lpdon/xmobile/README.md

# X-Mobile #

### What is this repository for? ###

Repository for the development of the version 2015 of the X-Mobile robot.
