lpdon/xmobile/remote control/Conectores.brd

## EAGLE design remote control/Conectores.brd (2015-06-17)

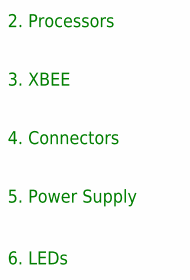
[picture p1: schematic Conectores.sch, sheet 1]

Notes on the sheet:
2. Processors
3. XBEE
4. Connectors
5. Power Supply
6. LEDs

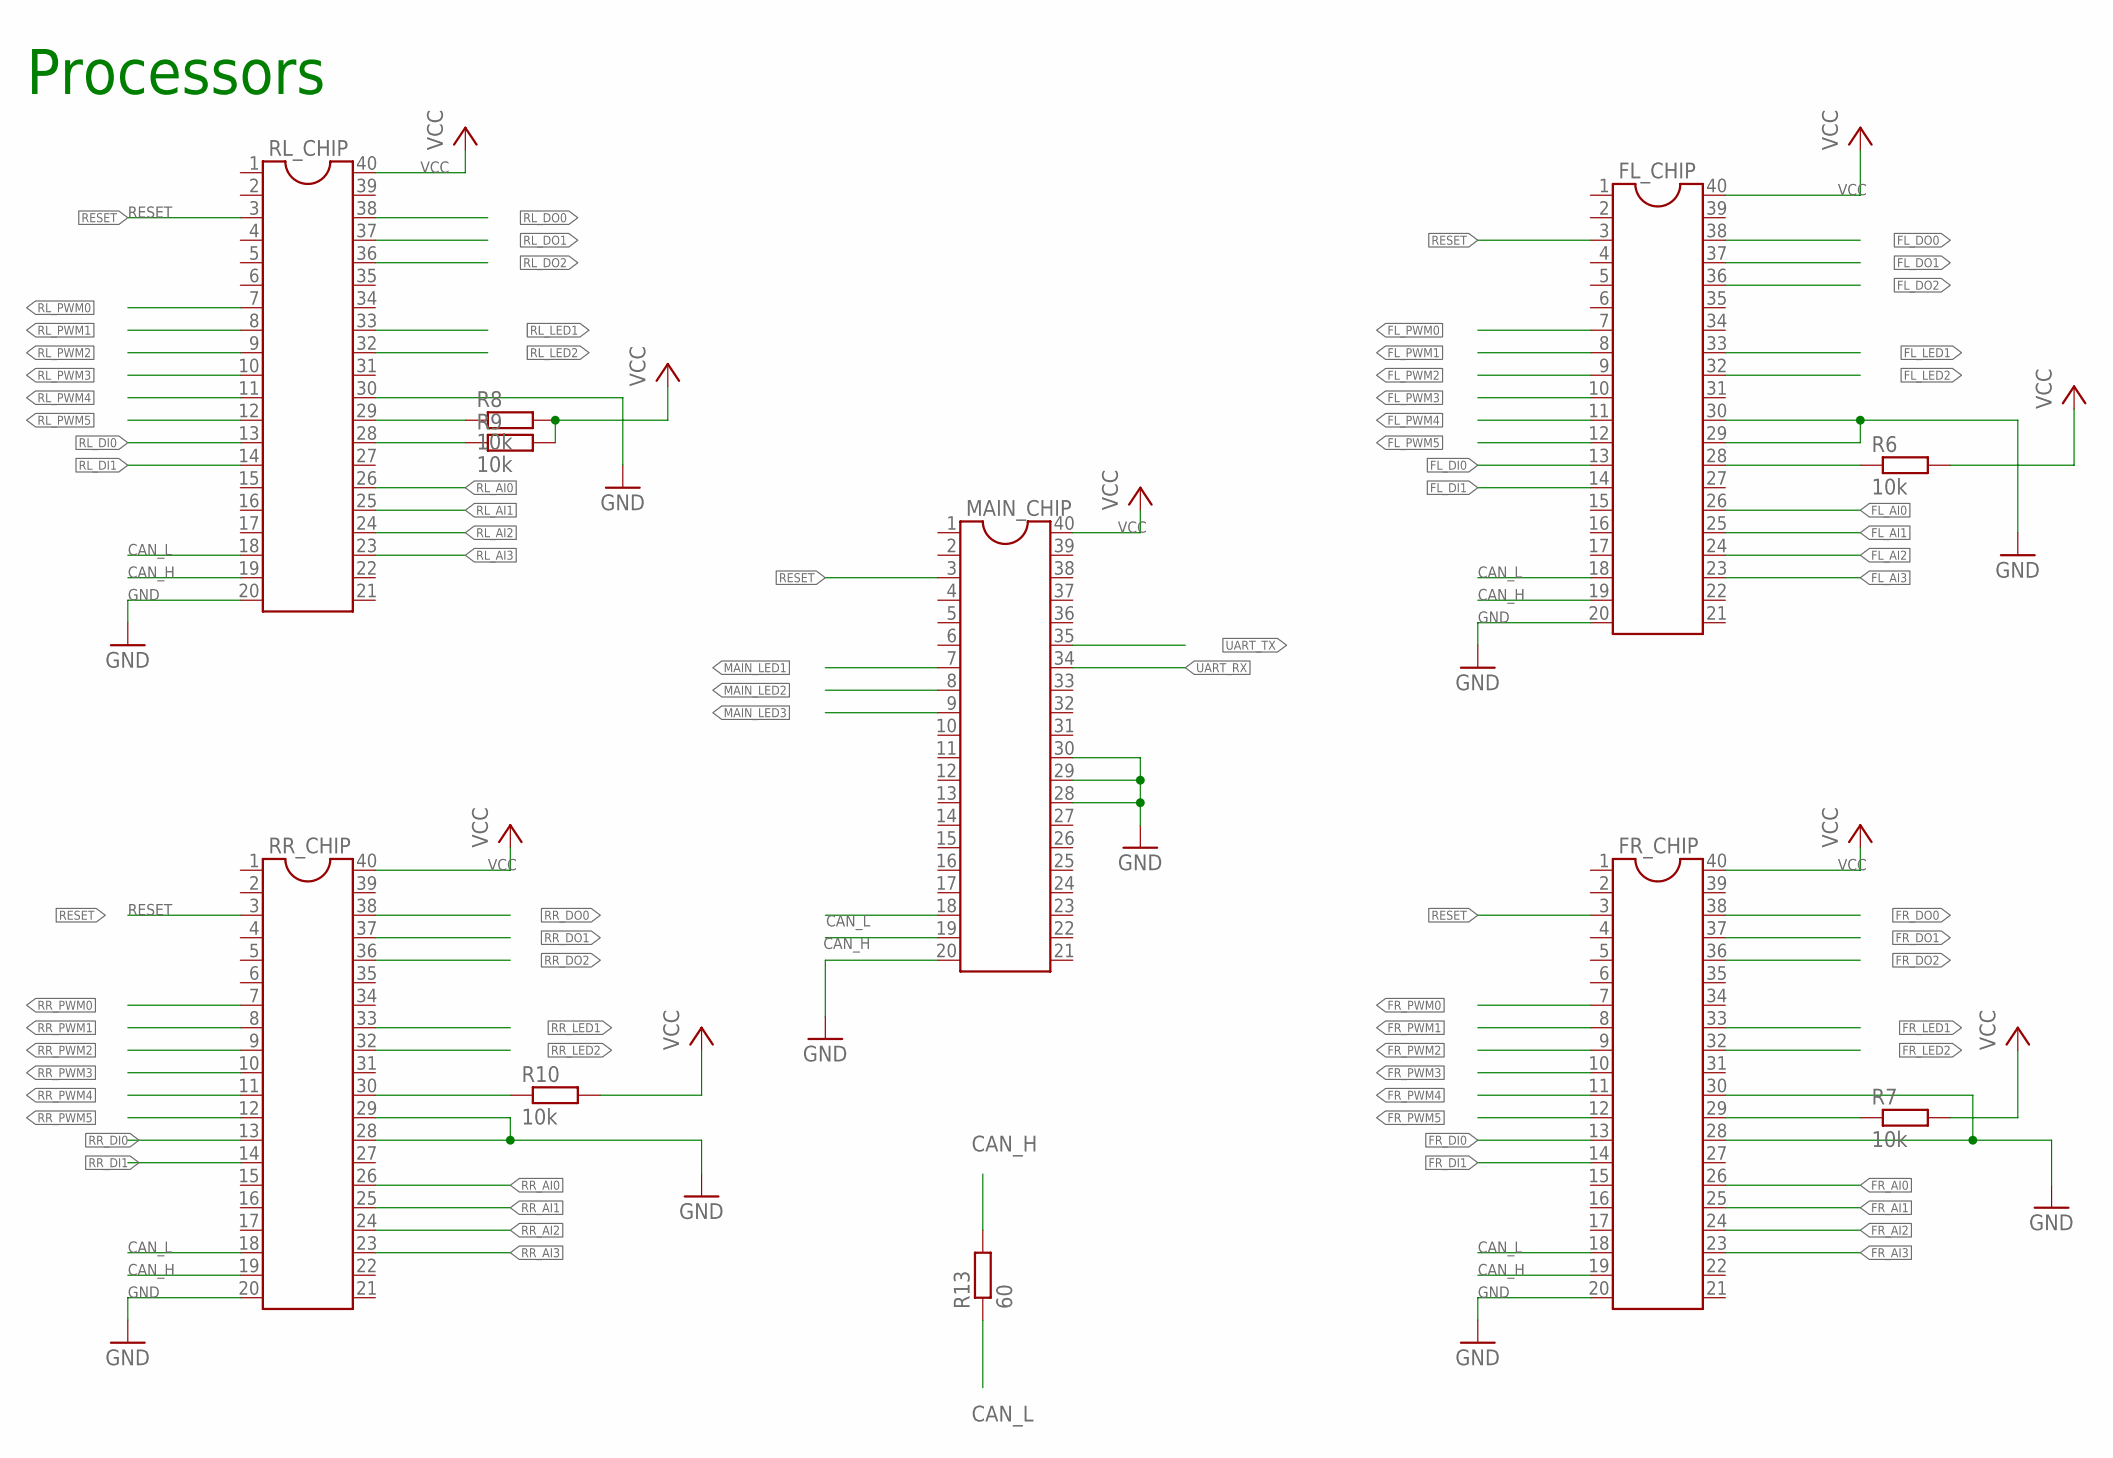
[picture p2: schematic Conectores.sch, sheet 2]

Parts:
FL_CHIP: DIL40
FR_CHIP: DIL40
MAIN_CHIP: DIL40
R6, R7, R8, R9, R10: 10k; M0805
R13: 60; R0805
RL_CHIP: DIL40
RR_CHIP: DIL40

Connections:
CAN_H: FL_CHIP.19, FR_CHIP.19, MAIN_CHIP.19, R13.2, RL_CHIP.19, RR_CHIP.19; also elsewhere on the board
CAN_L: FL_CHIP.18, FR_CHIP.18, MAIN_CHIP.18, R13.1, RL_CHIP.18, RR_CHIP.18; also elsewhere on the board
FL_AI0: FL_CHIP.26; also elsewhere on the board
FL_AI1: FL_CHIP.25; also elsewhere on the board
FL_AI2: FL_CHIP.24; also elsewhere on the board
FL_AI3: FL_CHIP.23; also elsewhere on the board
FL_DI0: FL_CHIP.13; also elsewhere on the board
FL_DI1: FL_CHIP.14; also elsewhere on the board
FL_DO0: FL_CHIP.38; also elsewhere on the board
FL_DO1: FL_CHIP.37; also elsewhere on the board
FL_DO2: FL_CHIP.36; also elsewhere on the board
FL_LED1: FL_CHIP.33; also elsewhere on the board
FL_LED2: FL_CHIP.32; also elsewhere on the board
FL_PWM0: FL_CHIP.7; also elsewhere on the board
FL_PWM1: FL_CHIP.8; also elsewhere on the board
FL_PWM2: FL_CHIP.9; also elsewhere on the board
FL_PWM3: FL_CHIP.10; also elsewhere on the board
FL_PWM4: FL_CHIP.11; also elsewhere on the board
FL_PWM5: FL_CHIP.12; also elsewhere on the board
FR_AI0: FR_CHIP.26; also elsewhere on the board
FR_AI1: FR_CHIP.25; also elsewhere on the board
FR_AI2: FR_CHIP.24; also elsewhere on the board
FR_AI3: FR_CHIP.23; also elsewhere on the board
FR_DI0: FR_CHIP.13; also elsewhere on the board
FR_DI1: FR_CHIP.14; also elsewhere on the board
FR_DIP2: FR_CHIP.29, R7.1
FR_DO0: FR_CHIP.38; also elsewhere on the board
FR_DO1: FR_CHIP.37; also elsewhere on the board
FR_DO2: FR_CHIP.36; also elsewhere on the board
FR_LED1: FR_CHIP.33; also elsewhere on the board
FR_LED2: FR_CHIP.32; also elsewhere on the board
FR_PWM0: FR_CHIP.7; also elsewhere on the board
FR_PWM1: FR_CHIP.8; also elsewhere on the board
FR_PWM2: FR_CHIP.9; also elsewhere on the board
FR_PWM3: FR_CHIP.10; also elsewhere on the board
FR_PWM4: FR_CHIP.11; also elsewhere on the board
FR_PWM5: FR_CHIP.12; also elsewhere on the board
GND: FL_CHIP.20, FL_CHIP.29, FL_CHIP.30, FR_CHIP.20, FR_CHIP.28, FR_CHIP.30, MAIN_CHIP.20, MAIN_CHIP.28, MAIN_CHIP.29, MAIN_CHIP.30, RL_CHIP.20, RL_CHIP.30, RR_CHIP.20, RR_CHIP.28, RR_CHIP.29; also elsewhere on the board
MAIN_LED1: MAIN_CHIP.7; also elsewhere on the board
MAIN_LED2: MAIN_CHIP.8; also elsewhere on the board
MAIN_LED3: MAIN_CHIP.9; also elsewhere on the board
unnamed: FL_CHIP.28, R6.1
RESET: FL_CHIP.3, FR_CHIP.3, MAIN_CHIP.3, RL_CHIP.3, RR_CHIP.3; also elsewhere on the board
RL_AI0: RL_CHIP.26; also elsewhere on the board
RL_AI1: RL_CHIP.25; also elsewhere on the board
RL_AI2: RL_CHIP.24; also elsewhere on the board
RL_AI3: RL_CHIP.23; also elsewhere on the board
RL_DI0: RL_CHIP.13; also elsewhere on the board
RL_DI1: RL_CHIP.14; also elsewhere on the board
RL_DIP2: R8.1, RL_CHIP.29
RL_DIP3: R9.1, RL_CHIP.28
RL_DO0: RL_CHIP.38; also elsewhere on the board
RL_DO1: RL_CHIP.37; also elsewhere on the board
RL_DO2: RL_CHIP.36; also elsewhere on the board
RL_LED1: RL_CHIP.33; also elsewhere on the board
RL_LED2: RL_CHIP.32; also elsewhere on the board
RL_PWM0: RL_CHIP.7; also elsewhere on the board
RL_PWM1: RL_CHIP.8; also elsewhere on the board
RL_PWM2: RL_CHIP.9; also elsewhere on the board
RL_PWM3: RL_CHIP.10; also elsewhere on the board
RL_PWM4: RL_CHIP.11; also elsewhere on the board
RL_PWM5: RL_CHIP.12; also elsewhere on the board
RR_AI0: RR_CHIP.26; also elsewhere on the board
RR_AI1: RR_CHIP.25; also elsewhere on the board
RR_AI2: RR_CHIP.24; also elsewhere on the board
RR_AI3: RR_CHIP.23; also elsewhere on the board
RR_DI0: RR_CHIP.13; also elsewhere on the board
RR_DI1: RR_CHIP.14; also elsewhere on the board
RR_DIP1: R10.1, RR_CHIP.30
RR_DO0: RR_CHIP.38; also elsewhere on the board
RR_DO1: RR_CHIP.37; also elsewhere on the board
RR_DO2: RR_CHIP.36; also elsewhere on the board
RR_LED1: RR_CHIP.33; also elsewhere on the board
RR_LED2: RR_CHIP.32; also elsewhere on the board
RR_PWM0: RR_CHIP.7; also elsewhere on the board
RR_PWM1: RR_CHIP.8; also elsewhere on the board
RR_PWM2: RR_CHIP.9; also elsewhere on the board
RR_PWM3: RR_CHIP.10; also elsewhere on the board
RR_PWM4: RR_CHIP.11; also elsewhere on the board
RR_PWM5: RR_CHIP.12; also elsewhere on the board
UART_RX: MAIN_CHIP.34; also elsewhere on the board
UART_TX: MAIN_CHIP.35; also elsewhere on the board
VCC: FL_CHIP.40, FR_CHIP.40, MAIN_CHIP.40, R6.2, R7.2, R8.2, R9.2, R10.2, RL_CHIP.40, RR_CHIP.40; also elsewhere on the board

Notes on the sheet:
Processors

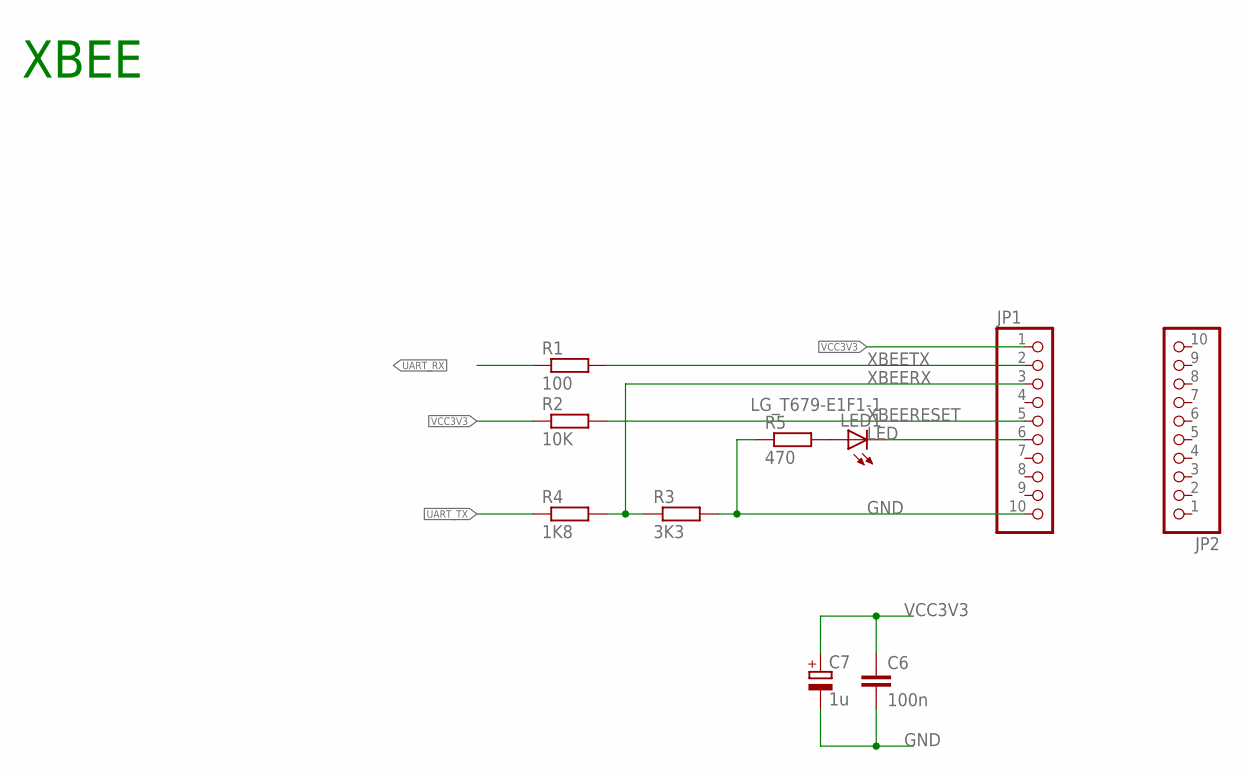
[picture p3: schematic Conectores.sch, sheet 3]

Parts:
C6: 100n; C0805
C7: 1u; CT3528
JP1, JP2: PINHD-1X10_2.00; 1X10M
LED1: LG_T679-E1F1-1; PLCC2
R1: 100; M0805
R2: 10K; M0805
R3: 3K3; M0805
R4: 1K8; M0805
R5: 470; M0805

Connections:
GND: C6.2, C7.-, JP1.10, R3.2, R5.1; also elsewhere on the board
LED: JP1.6, LED1.C
unnamed: LED1.A, R5.2
UART_RX: R1.1; also elsewhere on the board
UART_TX: R4.1; also elsewhere on the board
VCC3V3: C6.1, C7.+, JP1.1, R2.1; also elsewhere on the board
XBEERESET: JP1.5, R2.2
XBEERX: JP1.3, R3.1, R4.2
XBEETX: JP1.2, R1.2

Notes on the sheet:
XBEE

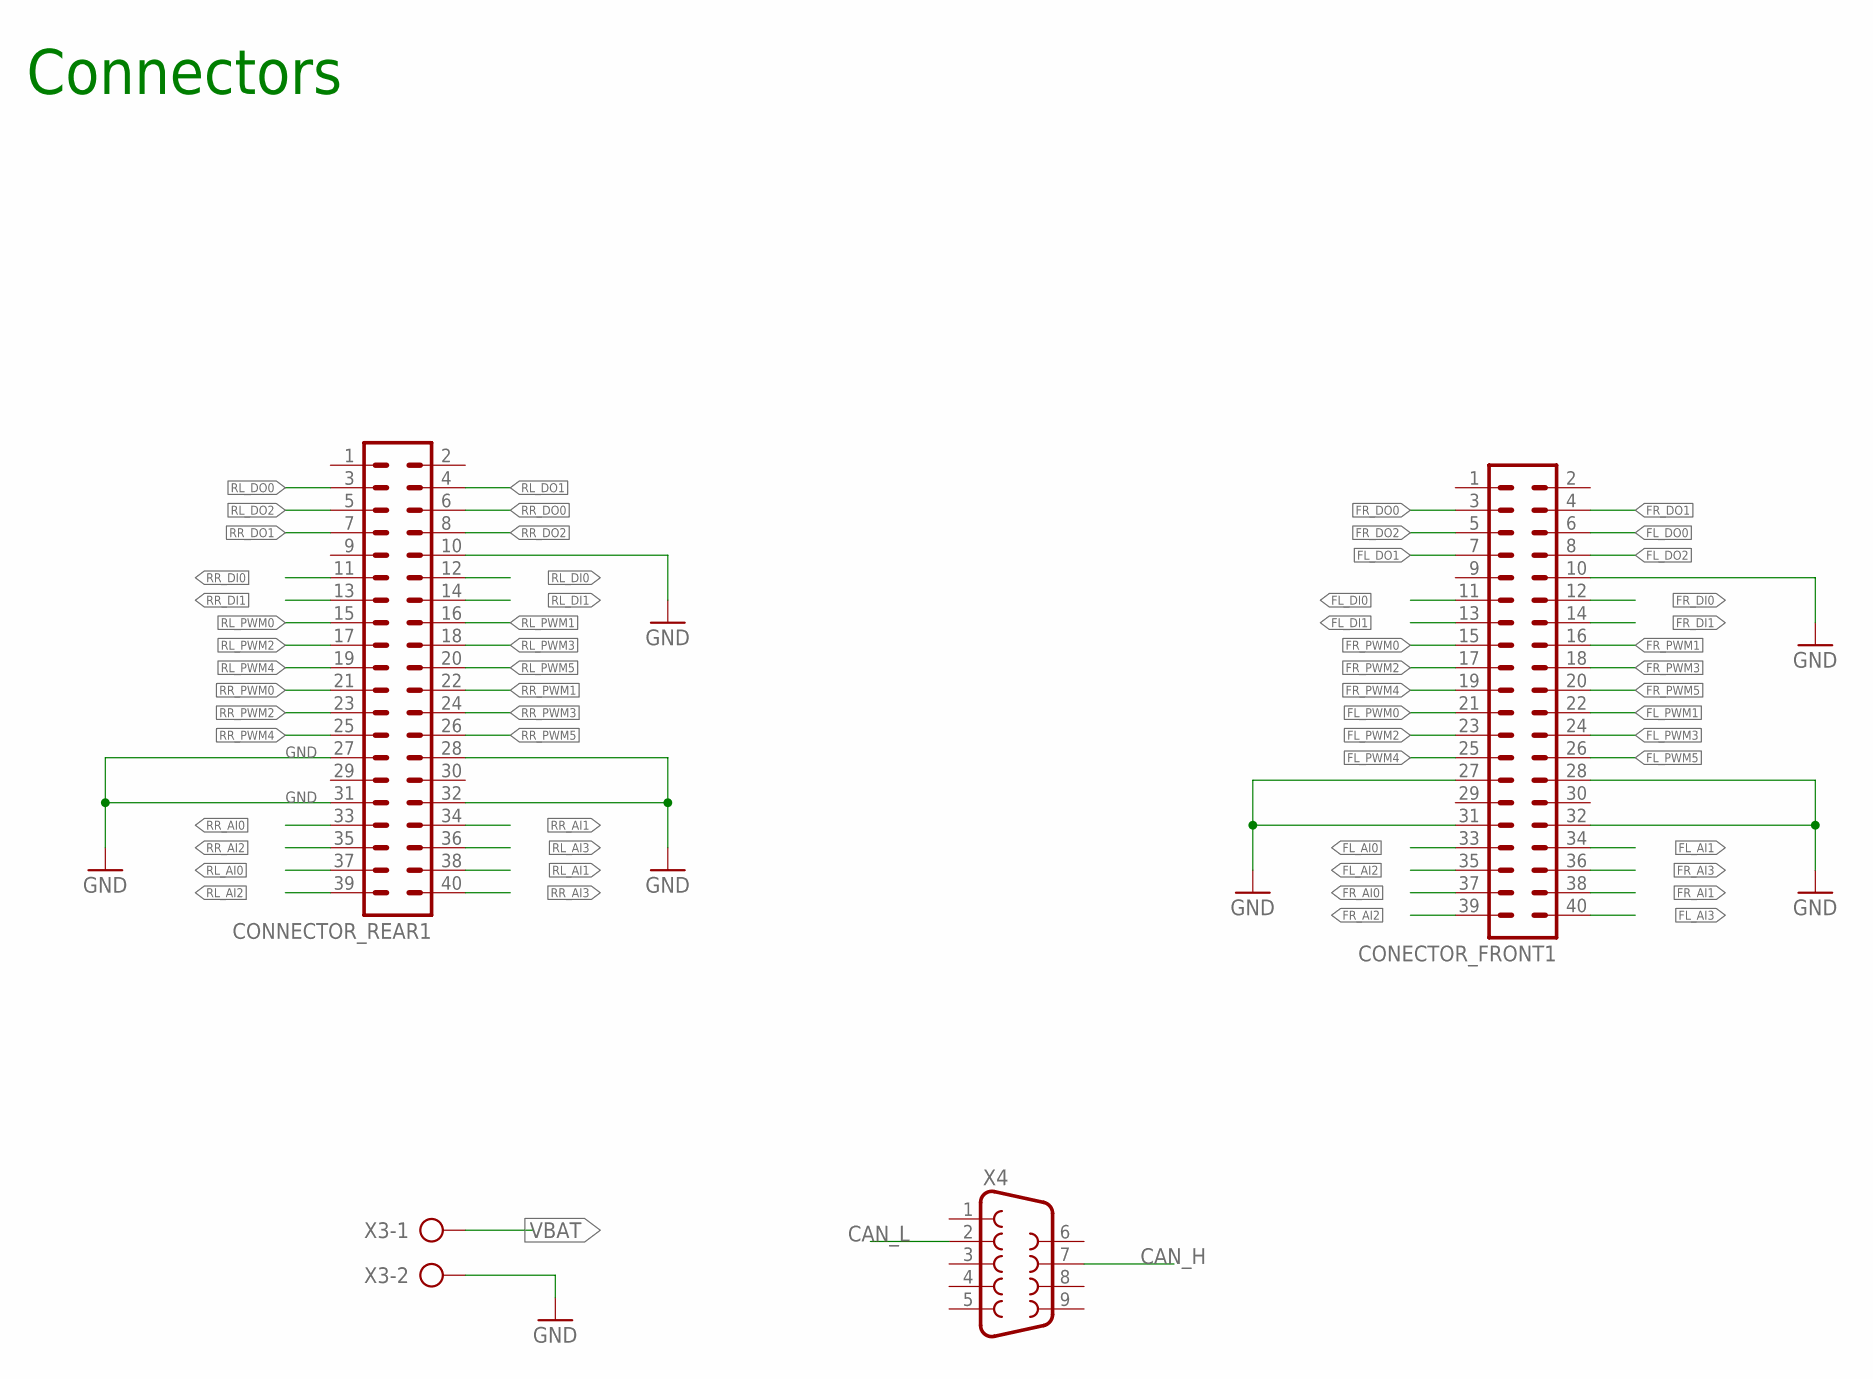
[picture p4: schematic Conectores.sch, sheet 4]

Parts:
CONECTOR_FRONT1: ML40
CONNECTOR_REAR1: ML40
X3: AK300/2
X4: F09HP

Connections:
CAN_H: X4.7; also elsewhere on the board
CAN_L: X4.2; also elsewhere on the board
FL_AI0: CONECTOR_FRONT1.33; also elsewhere on the board
FL_AI1: CONECTOR_FRONT1.34; also elsewhere on the board
FL_AI2: CONECTOR_FRONT1.35; also elsewhere on the board
FL_AI3: CONECTOR_FRONT1.40; also elsewhere on the board
FL_DI0: CONECTOR_FRONT1.11; also elsewhere on the board
FL_DI1: CONECTOR_FRONT1.13; also elsewhere on the board
FL_DO0: CONECTOR_FRONT1.6; also elsewhere on the board
FL_DO1: CONECTOR_FRONT1.7; also elsewhere on the board
FL_DO2: CONECTOR_FRONT1.8; also elsewhere on the board
FL_PWM0: CONECTOR_FRONT1.21; also elsewhere on the board
FL_PWM1: CONECTOR_FRONT1.22; also elsewhere on the board
FL_PWM2: CONECTOR_FRONT1.23; also elsewhere on the board
FL_PWM3: CONECTOR_FRONT1.24; also elsewhere on the board
FL_PWM4: CONECTOR_FRONT1.25; also elsewhere on the board
FL_PWM5: CONECTOR_FRONT1.26; also elsewhere on the board
FR_AI0: CONECTOR_FRONT1.37; also elsewhere on the board
FR_AI1: CONECTOR_FRONT1.38; also elsewhere on the board
FR_AI2: CONECTOR_FRONT1.39; also elsewhere on the board
FR_AI3: CONECTOR_FRONT1.36; also elsewhere on the board
FR_DI0: CONECTOR_FRONT1.12; also elsewhere on the board
FR_DI1: CONECTOR_FRONT1.14; also elsewhere on the board
FR_DO0: CONECTOR_FRONT1.3; also elsewhere on the board
FR_DO1: CONECTOR_FRONT1.4; also elsewhere on the board
FR_DO2: CONECTOR_FRONT1.5; also elsewhere on the board
FR_PWM0: CONECTOR_FRONT1.15; also elsewhere on the board
FR_PWM1: CONECTOR_FRONT1.16; also elsewhere on the board
FR_PWM2: CONECTOR_FRONT1.17; also elsewhere on the board
FR_PWM3: CONECTOR_FRONT1.18; also elsewhere on the board
FR_PWM4: CONECTOR_FRONT1.19; also elsewhere on the board
FR_PWM5: CONECTOR_FRONT1.20; also elsewhere on the board
GND: CONECTOR_FRONT1.10, CONECTOR_FRONT1.27, CONECTOR_FRONT1.28, CONECTOR_FRONT1.31, CONECTOR_FRONT1.32, CONNECTOR_REAR1.10, CONNECTOR_REAR1.27, CONNECTOR_REAR1.28, CONNECTOR_REAR1.31, CONNECTOR_REAR1.32, X3.2; also elsewhere on the board
RL_AI0: CONNECTOR_REAR1.37; also elsewhere on the board
RL_AI1: CONNECTOR_REAR1.38; also elsewhere on the board
RL_AI2: CONNECTOR_REAR1.39; also elsewhere on the board
RL_AI3: CONNECTOR_REAR1.36; also elsewhere on the board
RL_DI0: CONNECTOR_REAR1.12; also elsewhere on the board
RL_DI1: CONNECTOR_REAR1.14; also elsewhere on the board
RL_DO0: CONNECTOR_REAR1.3; also elsewhere on the board
RL_DO1: CONNECTOR_REAR1.4; also elsewhere on the board
RL_DO2: CONNECTOR_REAR1.5; also elsewhere on the board
RL_PWM0: CONNECTOR_REAR1.15; also elsewhere on the board
RL_PWM1: CONNECTOR_REAR1.16; also elsewhere on the board
RL_PWM2: CONNECTOR_REAR1.17; also elsewhere on the board
RL_PWM3: CONNECTOR_REAR1.18; also elsewhere on the board
RL_PWM4: CONNECTOR_REAR1.19; also elsewhere on the board
RL_PWM5: CONNECTOR_REAR1.20; also elsewhere on the board
RR_AI0: CONNECTOR_REAR1.33; also elsewhere on the board
RR_AI1: CONNECTOR_REAR1.34; also elsewhere on the board
RR_AI2: CONNECTOR_REAR1.35; also elsewhere on the board
RR_AI3: CONNECTOR_REAR1.40; also elsewhere on the board
RR_DI0: CONNECTOR_REAR1.11; also elsewhere on the board
RR_DI1: CONNECTOR_REAR1.13; also elsewhere on the board
RR_DO0: CONNECTOR_REAR1.6; also elsewhere on the board
RR_DO1: CONNECTOR_REAR1.7; also elsewhere on the board
RR_DO2: CONNECTOR_REAR1.8; also elsewhere on the board
RR_PWM0: CONNECTOR_REAR1.21; also elsewhere on the board
RR_PWM1: CONNECTOR_REAR1.22; also elsewhere on the board
RR_PWM2: CONNECTOR_REAR1.23; also elsewhere on the board
RR_PWM3: CONNECTOR_REAR1.24; also elsewhere on the board
RR_PWM4: CONNECTOR_REAR1.25; also elsewhere on the board
RR_PWM5: CONNECTOR_REAR1.26; also elsewhere on the board
VBAT: X3.1; also elsewhere on the board

Notes on the sheet:
Connectors

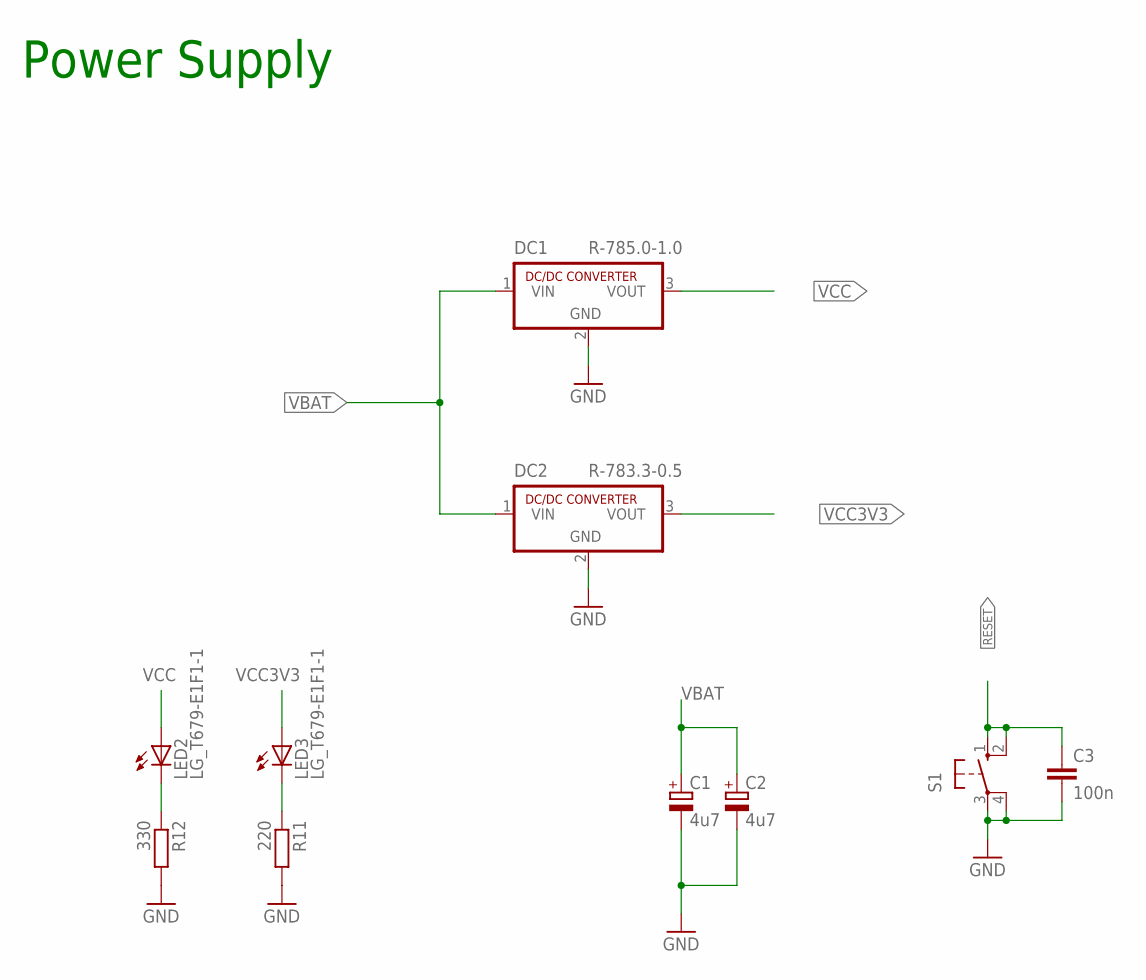
[picture p5: schematic Conectores.sch, sheet 5]

Parts:
C1, C2: 4u7; SMC_E
C3: 100n; C0805K
DC1: R-785.0-1.0; SIP3
DC2: R-783.3-0.5; SIP3
LED2, LED3: LG_T679-E1F1-1; PLCC2
R11: 220; R0805
R12: 330; R0805
S1: 10-XX; B3F-10XX

Connections:
GND: C1.-, C2.-, C3.2, DC1.2 (GND), DC2.2 (GND), R11.2, R12.2, S1.3, S1.4 (P1); also elsewhere on the board
unnamed: LED3.C, R11.1
unnamed: LED2.C, R12.1
RESET: C3.1, S1.1 (S), S1.2 (S1); also elsewhere on the board
VBAT: C1.+, C2.+, DC1.1 (VIN), DC2.1 (VIN); also elsewhere on the board
VCC: DC1.3 (VOUT), LED2.A; also elsewhere on the board
VCC3V3: DC2.3 (VOUT), LED3.A; also elsewhere on the board

Notes on the sheet:
Power Supply

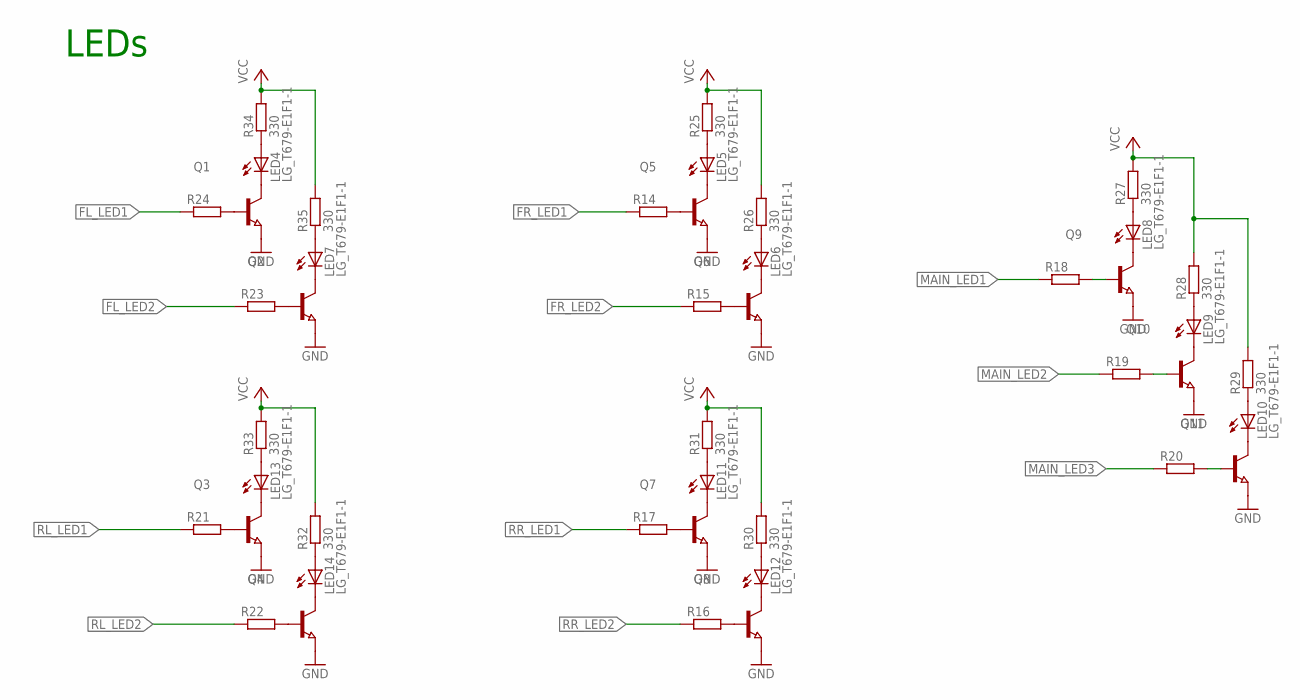
[picture p6: schematic Conectores.sch, sheet 6]

Parts:
LED4, LED5, LED6, LED7, LED8, LED9, LED10, LED11, LED12, LED13, LED14: LG_T679-E1F1-1; PLCC2
Q1, Q2, Q3, Q4, Q5, Q6, Q7, Q8, Q9, Q10, Q11: NPN-TRANSISTOR_SOT23; SOT23
R14, R15, R16, R17, R18, R19, R20, R21, R22, R23, R24: R-EU_R0805; R0805
R25, R26, R27, R28, R29, R30, R31, R32, R33, R34, R35: 330; R0805

Connections:
FL_LED1: R24.1; also elsewhere on the board
FL_LED2: R23.1; also elsewhere on the board
FR_LED1: R14.1; also elsewhere on the board
FR_LED2: R15.1; also elsewhere on the board
GND: Q1.2 (E), Q2.2 (E), Q3.2 (E), Q4.2 (E), Q5.2 (E), Q6.2 (E), Q7.2 (E), Q8.2 (E), Q9.2 (E), Q10.2 (E), Q11.2 (E); also elsewhere on the board
MAIN_LED1: R18.1; also elsewhere on the board
MAIN_LED2: R19.1; also elsewhere on the board
MAIN_LED3: R20.1; also elsewhere on the board
unnamed: Q5.1 (B), R14.2
unnamed: Q6.1 (B), R15.2
unnamed: Q8.1 (B), R16.2
unnamed: Q7.1 (B), R17.2
unnamed: Q3.1 (B), R21.2
unnamed: Q4.1 (B), R22.2
unnamed: Q1.1 (B), R24.2
unnamed: Q2.1 (B), R23.2
unnamed: LED4.C, Q1.3 (C)
unnamed: LED5.C, Q5.3 (C)
unnamed: LED8.C, Q9.3 (C)
unnamed: LED10.C, Q11.3 (C)
unnamed: LED11.C, Q7.3 (C)
unnamed: LED13.C, Q3.3 (C)
unnamed: LED7.C, Q2.3 (C)
unnamed: LED14.C, Q4.3 (C)
unnamed: LED6.C, Q6.3 (C)
unnamed: LED12.C, Q8.3 (C)
unnamed: LED9.C, Q10.3 (C)
unnamed: LED5.A, R25.1
unnamed: LED6.A, R26.1
unnamed: LED8.A, R27.1
unnamed: LED9.A, R28.1
unnamed: LED10.A, R29.1
unnamed: LED12.A, R30.1
unnamed: LED11.A, R31.1
unnamed: LED14.A, R32.1
unnamed: LED13.A, R33.1
unnamed: LED4.A, R34.1
unnamed: LED7.A, R35.1
unnamed: Q9.1 (B), R18.2
unnamed: Q10.1 (B), R19.2
unnamed: Q11.1 (B), R20.2
RL_LED1: R21.1; also elsewhere on the board
RL_LED2: R22.1; also elsewhere on the board
RR_LED1: R17.1; also elsewhere on the board
RR_LED2: R16.1; also elsewhere on the board
VCC: R25.2, R26.2, R27.2, R28.2, R29.2, R30.2, R31.2, R32.2, R33.2, R34.2, R35.2; also elsewhere on the board

Notes on the sheet:
LEDs

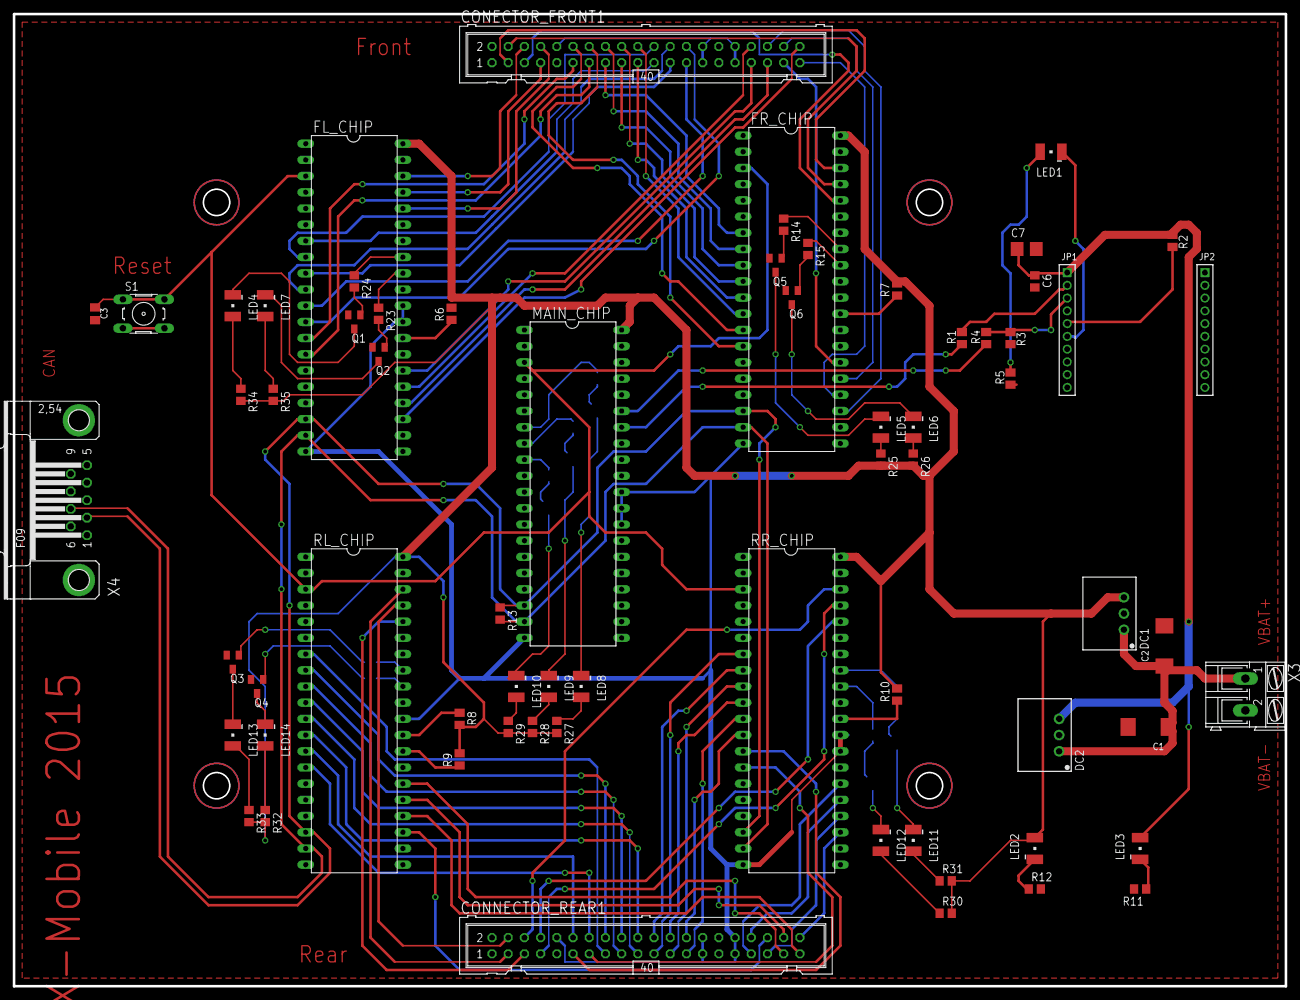
[picture p7: board Conectores.brd from above]

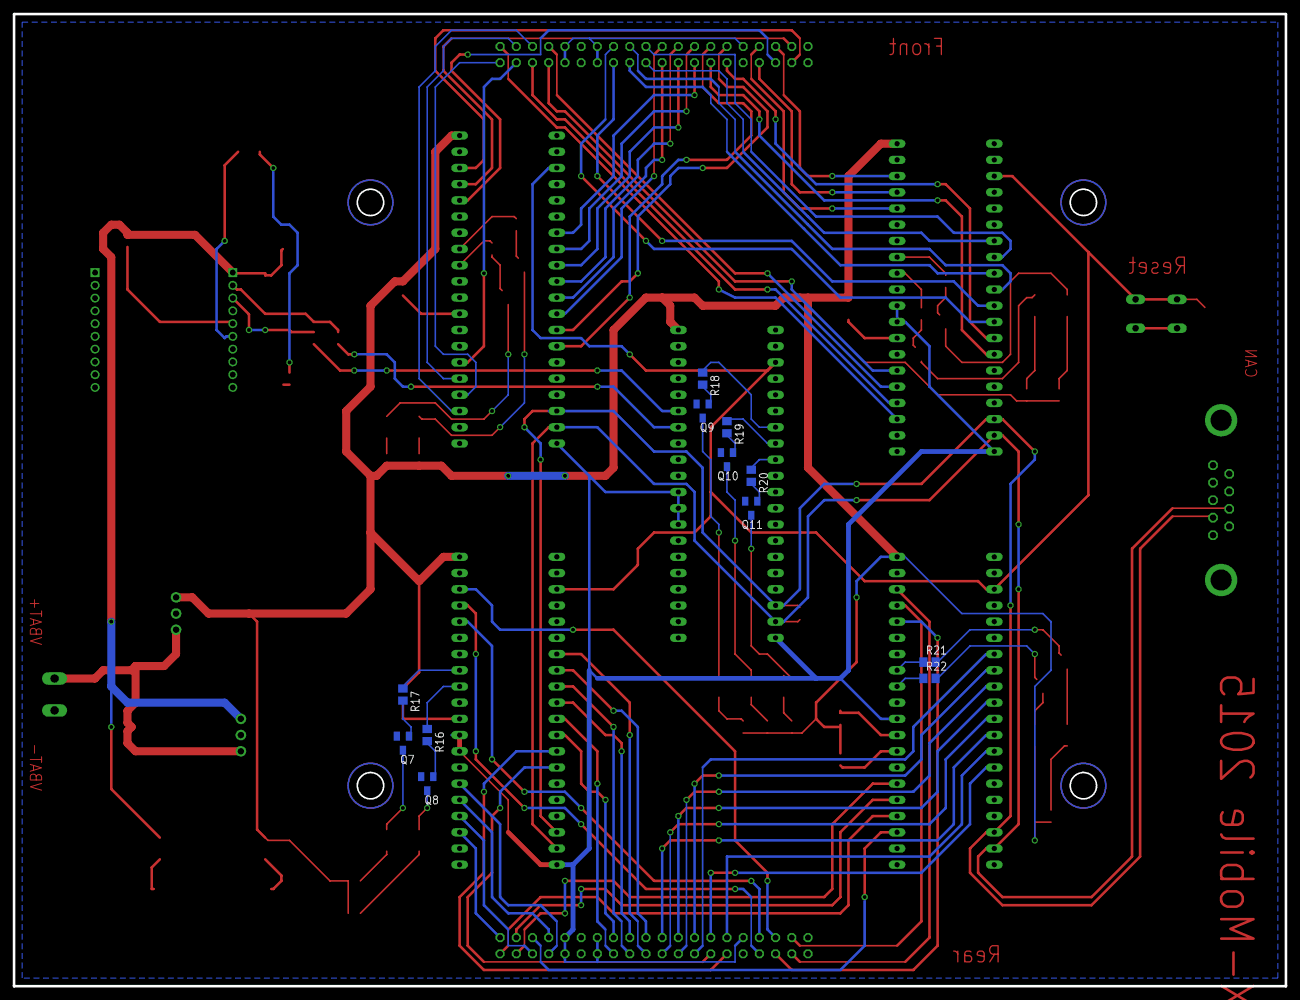
[picture p8: board Conectores.brd from below]

Board: 2 copper layers, 199.4 x 152.4 mm, 79 parts (12 on the bottom side), 125 nets.
