lpdon/xmobile/remote control/Remote Control.brd

## EAGLE design remote control/Remote Control.brd (2015-06-17)

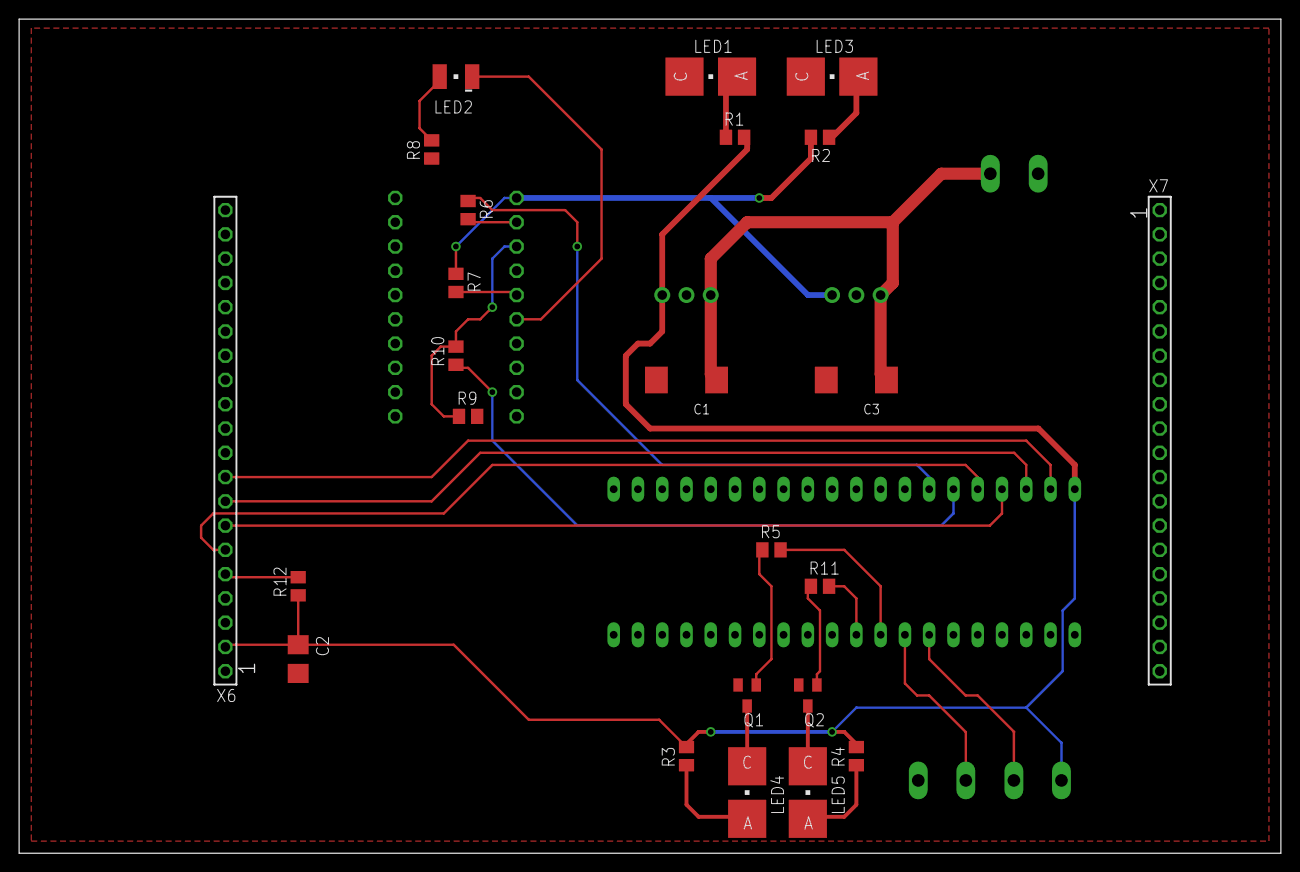
[picture p9: board Remote Control.brd from above]

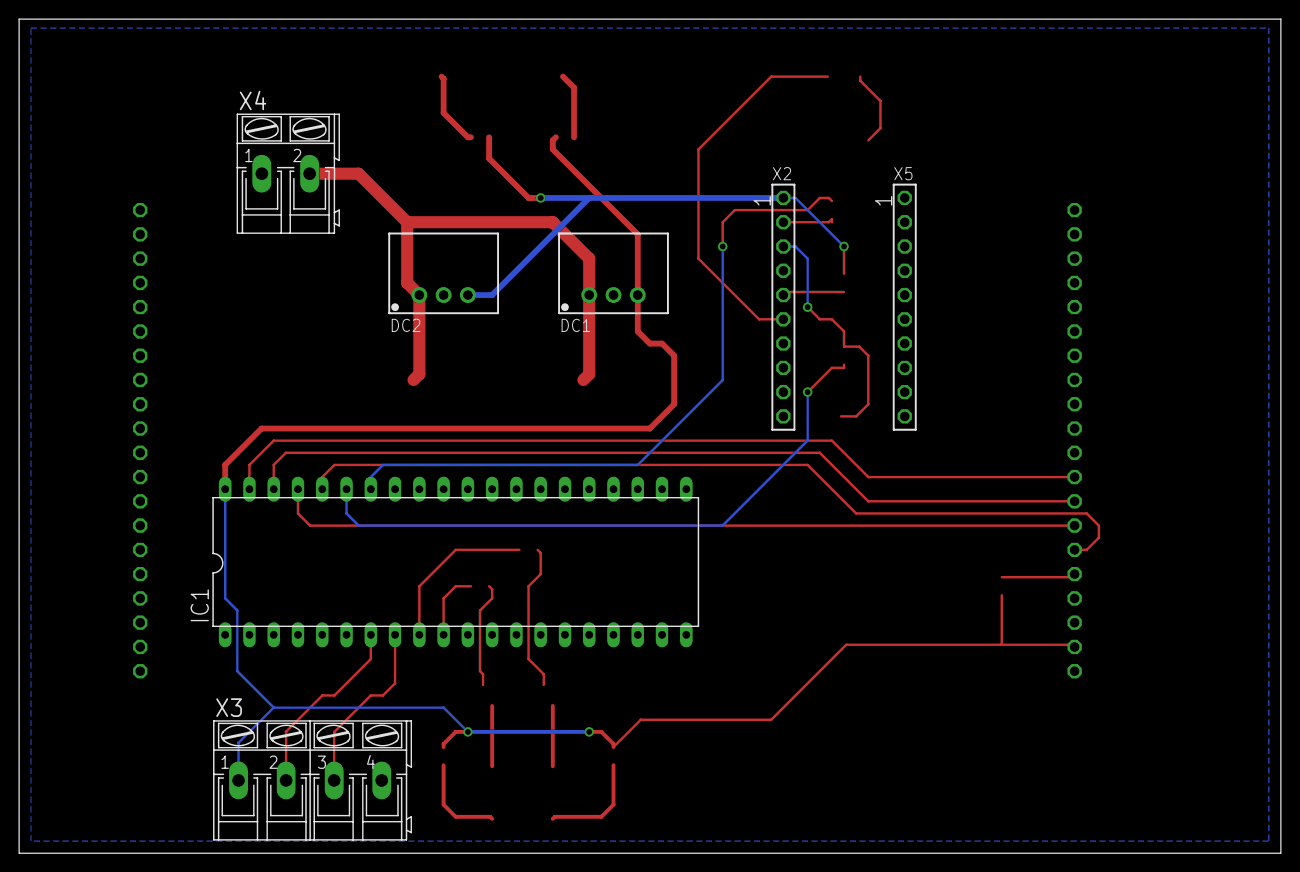
[picture p10: board Remote Control.brd from below]

Board: 2 copper layers, 132.1 x 87.3 mm, 31 parts (7 on the bottom side), 28 nets.

Parts:
C1, C3: 4u7; SMC_E
C2: 10u; CT3528
DC1: R-785.0-1.0; SIP3
DC2: R-783.3-0.5; SIP3
IC1: DIL40
LED1, LED3, LED4, LED5: P-LCC-2
LED2: LG_T679-E1F1-1; PLCC2
Q1, Q2: SOT23
R1, R3, R4: 330; M0805
R2: 220; M0805
R5, R11: 10k; M0805
R6: 100; M0805
R7, R12: 10K; M0805
R8: 470; M0805
R9: 3K3; M0805
R10: 1K8; M0805
X2, X5: SSW-110-02-S-S
X3: AK300/4
X4: AK300/2
X6, X7: SSW-120-02-S-S

Connections:
3V3: DC2.3, R2.2, R7.1, X2.1
5V: C2.+, DC1.3, IC1.40, R1.2, R3.2, R4.2, R12.1, X3.1, X6.2
GND: C1.-, C2.-, C3.-, DC1.2, DC2.2, IC1.20, LED1.C, LED3.C, Q1.2, Q2.2, R8.1, R9.2, X2.10, X3.4, X4.1, X6.1, X6.11
I2C_CLOCK: IC1.7, X3.2
I2C_DATA: IC1.8, X3.3
LED1: IC1.9, R5.2
LED2: IC1.10, R11.2
MISO: IC1.38, X6.8
MOSI: IC1.37, X6.7
unnamed: LED2.A, R8.2
unnamed: LED1.A, R1.1
unnamed: LED3.A, R2.1
unnamed: LED4.A, R3.1
unnamed: LED4.C, Q1.3
unnamed: LED5.A, R4.1
unnamed: LED5.C, Q2.3
unnamed: Q1.1, R5.1
unnamed: Q2.1, R11.1
unnamed: R12.2, X6.5
SCK: IC1.39, X6.9
SS: IC1.36, X6.6
UART_RX: IC1.34, R6.1
UART_TX: IC1.35, R10.1
VBAT: C1.+, C3.+, DC1.1, DC2.1, X4.2
XBEELED1: LED2.C, X2.6
XBEERESET1: R7.2, X2.5
XBEERX: R9.1, R10.2, X2.3
XBEETX: R6.2, X2.2
