lpdon/xmobile/(commit log)

2015-06-14 Codewarrior Project builded for UART test purposes
2015-06-14 Updates and UART for Windows tests
2015-06-16 Remote Control Schematics added
    [remote control.sch]
2015-06-17 Remote Control almost final version
    [Conectores.brd, Conectores.csv, Conectores.sch, Remote Control.brd]
2015-06-18 Updated PID
2015-06-18 PID ADC Test added
2015-06-18 Updated comm e pid
2015-06-21 Updates comm/crc/pid
2015-07-04 Max error added to pid
    [pid.c, pid.h]
2015-07-05 test pwm over xbee
2015-07-06 Updated comm and bugfixes
    [bus_interface.c, handshake.c, handshake.h]
2015-07-10 New libs + bugfixes
    [bus_interface.c, drive.c, drive.h]
2015-07-12 Boards and bugfixes
    [CPU_HCS12C.brd, CPU_HCS12C.sch]
2015-07-22 PID 32 bits and Drive 16 bits
2015-07-23 Opmode added, update comm, bugfixes
    [bus_interface.c, can_interface.c, drive.c]
